KartikeyaVeeramraju/rtos_dcdc_converter_design/ARM_Cortex_Control_Firmware/Core/Src/main.c

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

/* Includes ------------------------------------------------------------------*/
#include "main.h"

/* USER CODE BEGIN Includes */
#include <string.h>
#include <stdio.h>
#include "Manager.h"
/* USER CODE END Includes */

TIM_HandleTypeDef htim1;
TIM_HandleTypeDef htim8;

UART_HandleTypeDef huart2;

/* USER CODE BEGIN PV */
extern char buf[10];
uint32_t *p; //pointer pointing to the address of registers

/* USER CODE END PV */

void SystemClock_Config(void);
static void MX_GPIO_Init(void);
static void MX_TIM1_Init(void);
static void MX_TIM8_Init(void);
static void MX_USART2_UART_Init(void);
/**
  * @brief  The application entry point.
  * @retval int
  */
int main(void)
{
  /* USER CODE BEGIN 1 */
//uint8_t msg1[] = "Hello World!\n\r";
  /* USER CODE END 1 */

  /* MCU Configuration--------------------------------------------------------*/

  /* Reset of all peripherals, Initializes the Flash interface and the Systick. */

	HAL_Init();

  /* USER CODE BEGIN Init */
  Manager_init();
  /* USER CODE END Init */

  /* Configure the system clock */
  SystemClock_Config();

  /* Initialize all configured peripherals */
  MX_GPIO_Init();
  MX_TIM1_Init();
  MX_TIM8_Init();
  MX_USART2_UART_Init();
  /* USER CODE BEGIN 2 */

  //HAL_TIM_PWM_Start(&htim1, TIM_CHANNEL_4);
  //HAL_TIM_PWM_Start(&htim8, TIM_CHANNEL_4);
  HAL_UART_Receive_IT(&huart2, buf, 1);
  /* USER CODE END 2 */

  /* Infinite loop */
  /* USER CODE BEGIN WHILE */
  while (1)
  {
    /* USER CODE END WHILE */

    /* USER CODE BEGIN 3 */

  }
  /* USER CODE END 3 */
}

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
/* USER CODE BEGIN 4 */

void USART1_IRQHandler(void)
{

}

/* USER CODE END 4 */
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
