KartikeyaVeeramraju/rtos_dcdc_converter_design/ARM_Cortex_Control_Firmware/Test_project_udemy.ioc

Mcu.UserName=STM32F446RETx
PA11.Signal=S_TIM1_CH4
PA2.Signal=USART2_TX
PA3.Signal=USART2_RX
PA5.Signal=GPIO_Output
PA8.Signal=S_TIM1_CH1
PC13.Signal=GPXTI13
PC9.Signal=S_TIM8_CH4
PH0-OSC_IN.Signal=RCC_OSC_IN
PH1-OSC_OUT.Signal=RCC_OSC_OUT
